Aghead-B/Wall-Tag/design/gun/wiring-gun.png

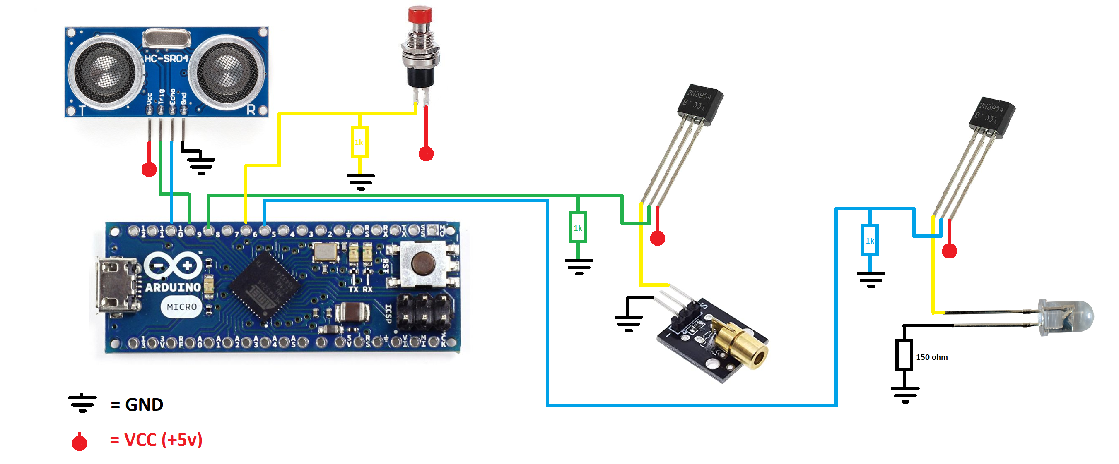
design/gun/wiring-gun.png
