Aghead-B/Wall-Tag/design/console/wiring-console.png

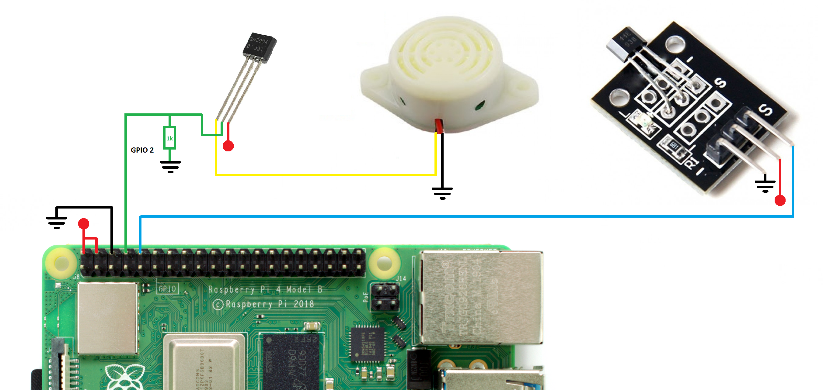
design/console/wiring-console.png
