Aghead-B/Wall-Tag/README.md

# Walltag

Looking for the prototype files? They can be found in the 'prototype' branch.
