Aghead-B/Wall-Tag/design/console/case/Console.step

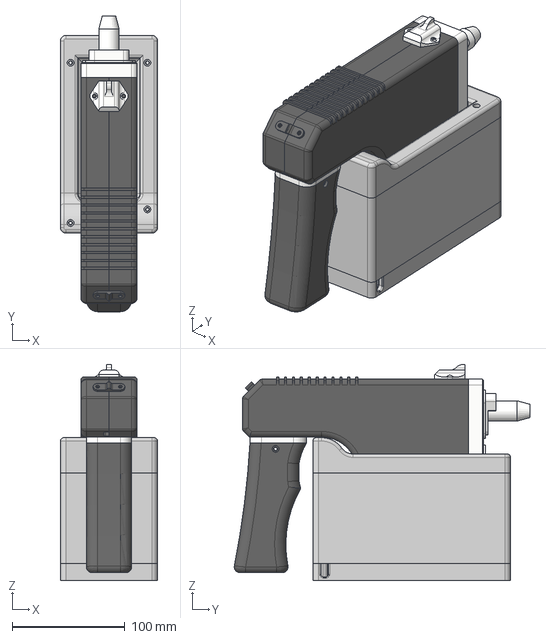
[picture p3: CAD file, 2021-01-11]
design/console/case/Console.step
86.0 x 261.6 x 191.2 mm
