Aghead-B/Wall-Tag/design/console/case/stl/Top.stl

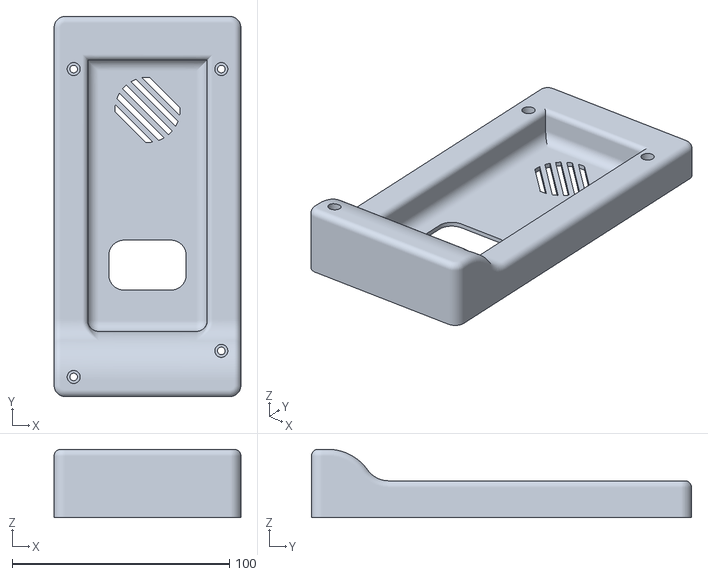
[picture p4: CAD file, 2021-01-11]
design/console/case/stl/Top.stl
86.0 x 175.0 x 31.5
