Aghead-B/Wall-Tag/design/gun/case/Gun.step

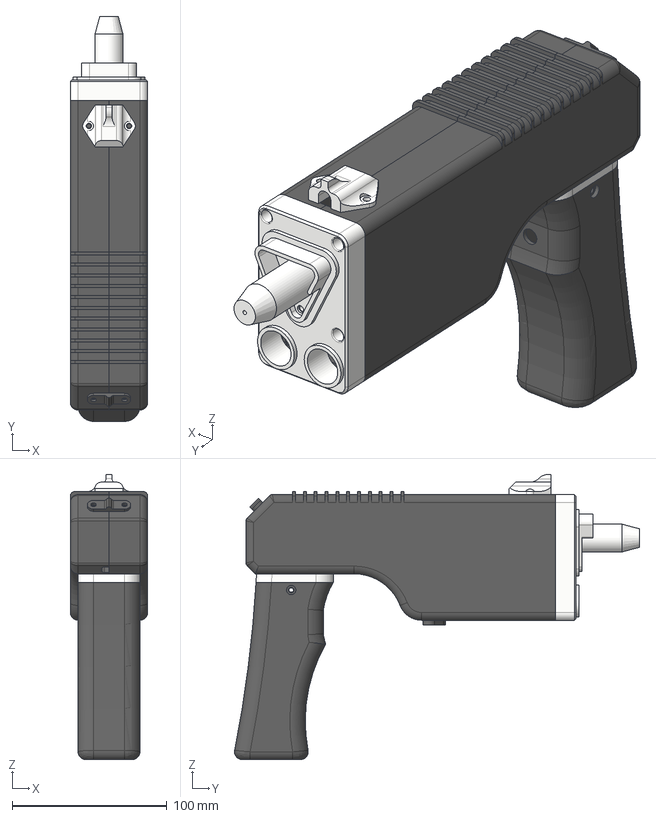
[picture p5: CAD file, 2021-01-11]
design/gun/case/Gun.step
50.0 x 261.6 x 184.2 mm
