Aghead-B/Wall-Tag/design/gun/case/stl/Front.stl

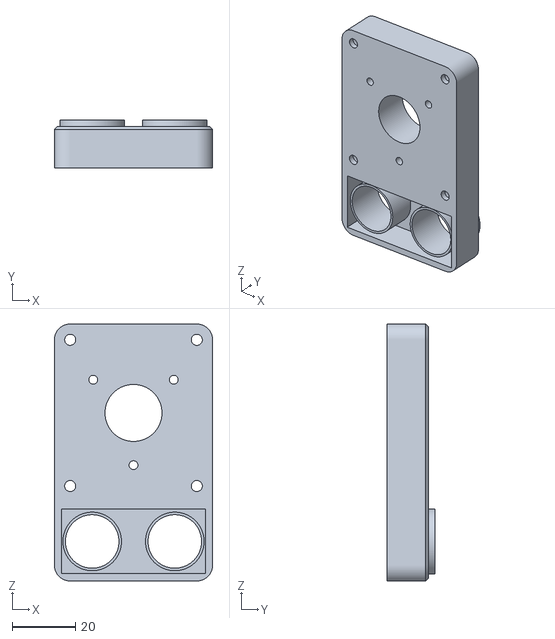
[picture p6: CAD file, 2021-01-11]
design/gun/case/stl/Front.stl
50.0 x 15.2 x 81.2
