Aghead-B/Wall-Tag/design/target-controller/case/Controller.step

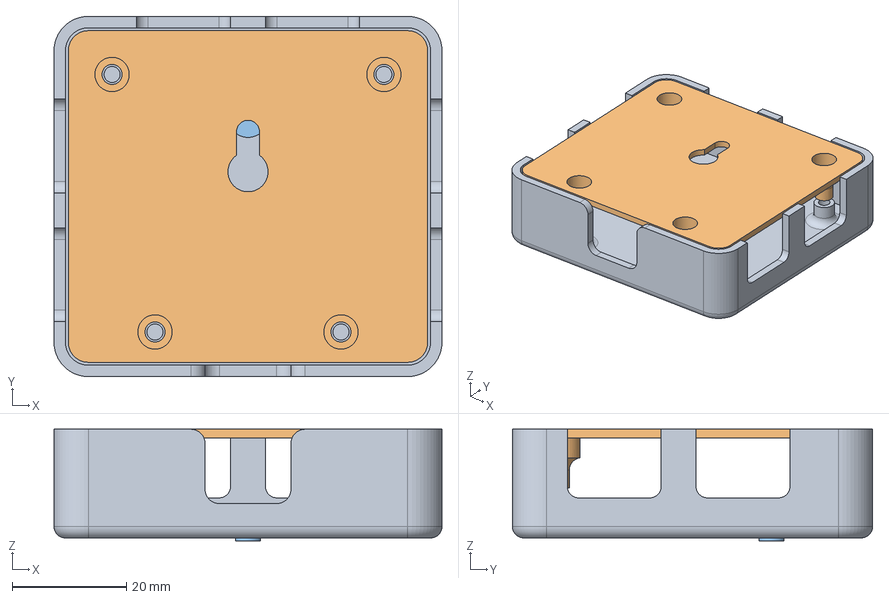
[picture p7: CAD file, 2021-01-11]
design/target-controller/case/Controller.step
67.8 x 63.0 x 19.5 mm
