Aghead-B/Wall-Tag/design/target-controller/case/stl/Case.stl

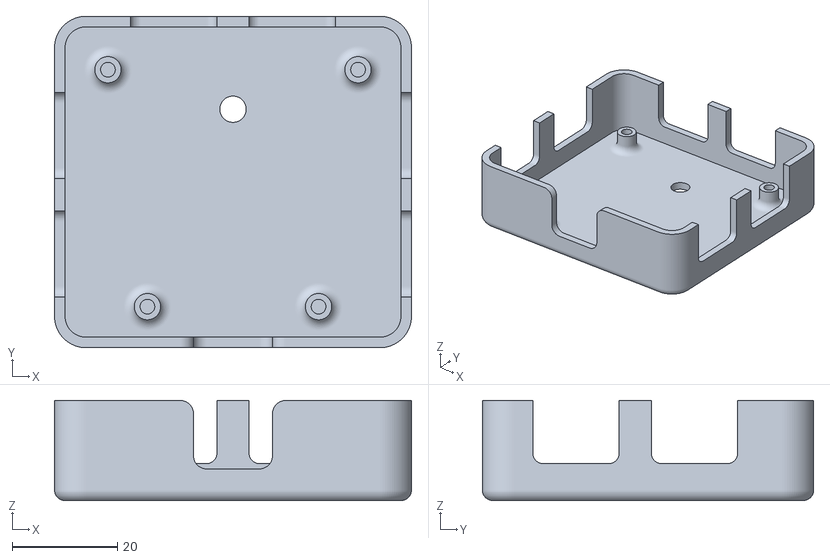
[picture p8: CAD file, 2021-01-11]
design/target-controller/case/stl/Case.stl
67.8 x 62.9 x 19.0
