Aghead-B/Wall-Tag/design/target/case/Target.step

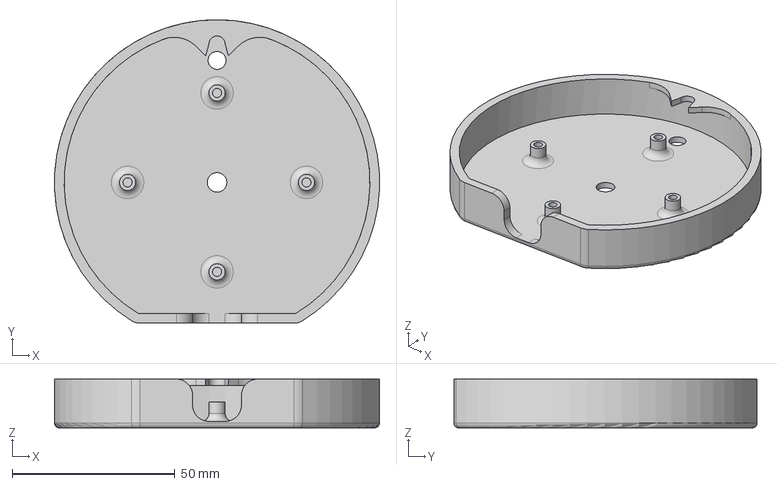
[picture p9: CAD file, 2021-01-11]
design/target/case/Target.step
99.9 x 93.3 x 15.0 mm
