Aghead-B/Wall-Tag/design/target/pcb/outline.dxf

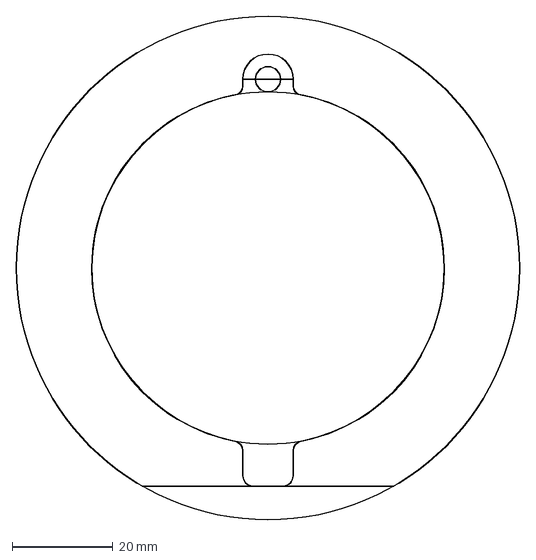
[picture p10: CAD file, 2020-11-24]
design/target/pcb/outline.dxf
100.0 x 100.0 mm
