Aghead-B/Wall-Tag/design/console/case/stl/Speaker mount.stl

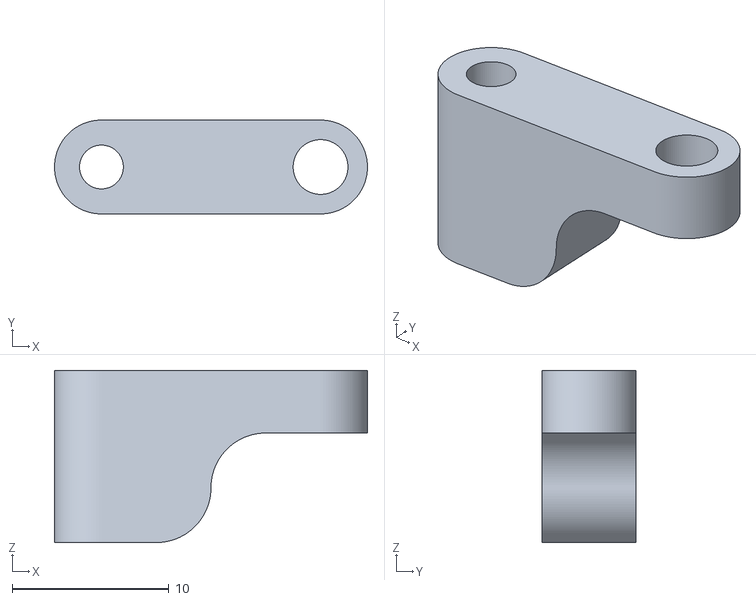
[picture p11: CAD file, 2021-01-11]
design/console/case/stl/Speaker mount.stl
20.0 x 6.00 x 11.0
