Aghead-B/Wall-Tag/design/gun/case/stl/Barrel.stl

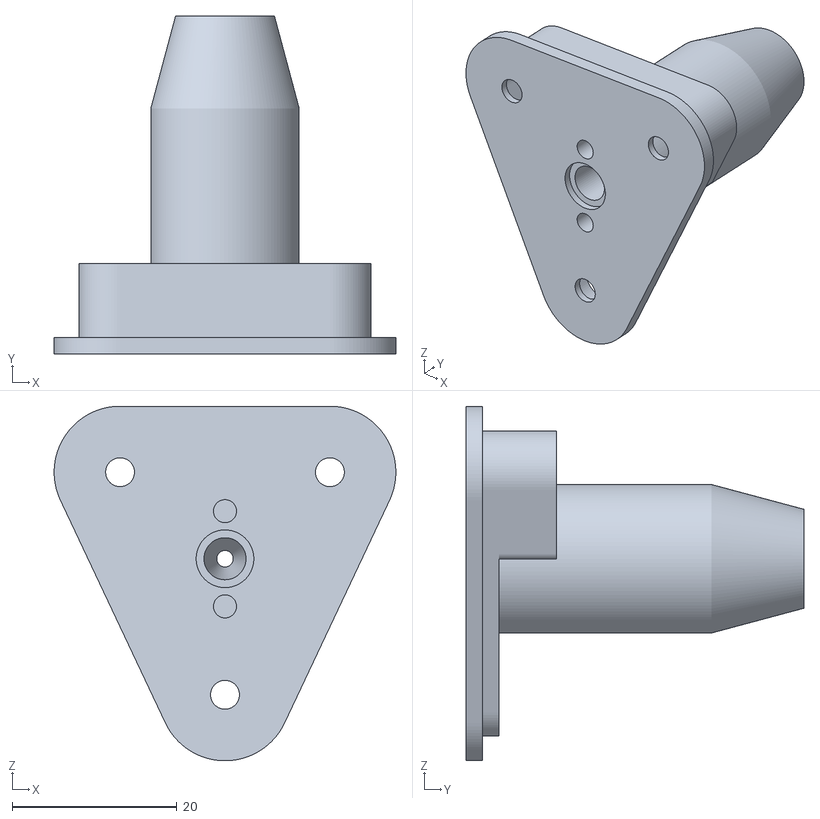
[picture p12: CAD file, 2021-01-11]
design/gun/case/stl/Barrel.stl
41.5 x 41.0 x 43.0
