Aghead-B/Wall-Tag/design/target-controller/case/stl/Button.stl

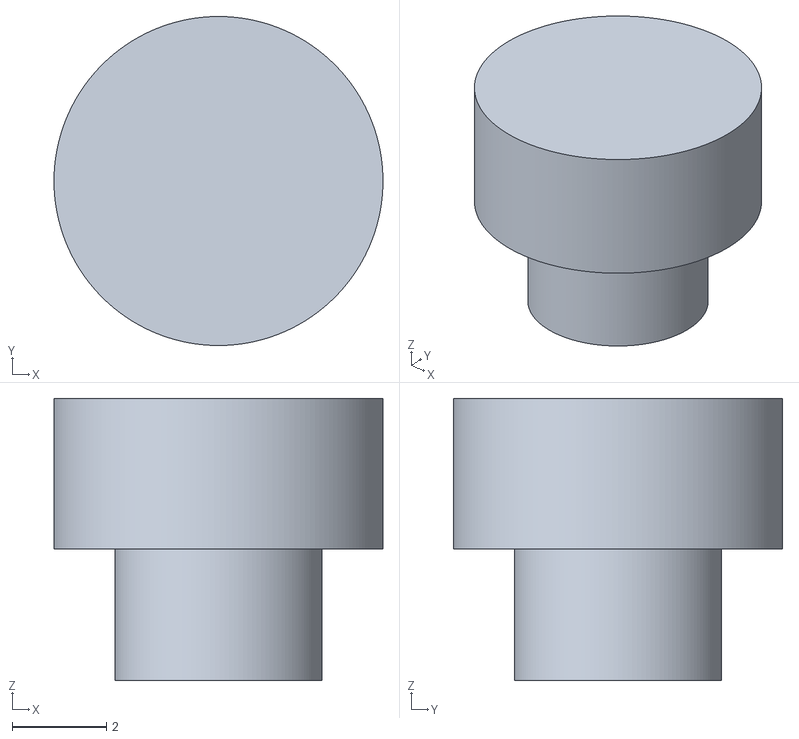
[picture p13: CAD file, 2021-01-11]
design/target-controller/case/stl/Button.stl
7.00 x 7.00 x 6.00
