Aghead-B/Wall-Tag/design/console/case/stl/Mid.stl

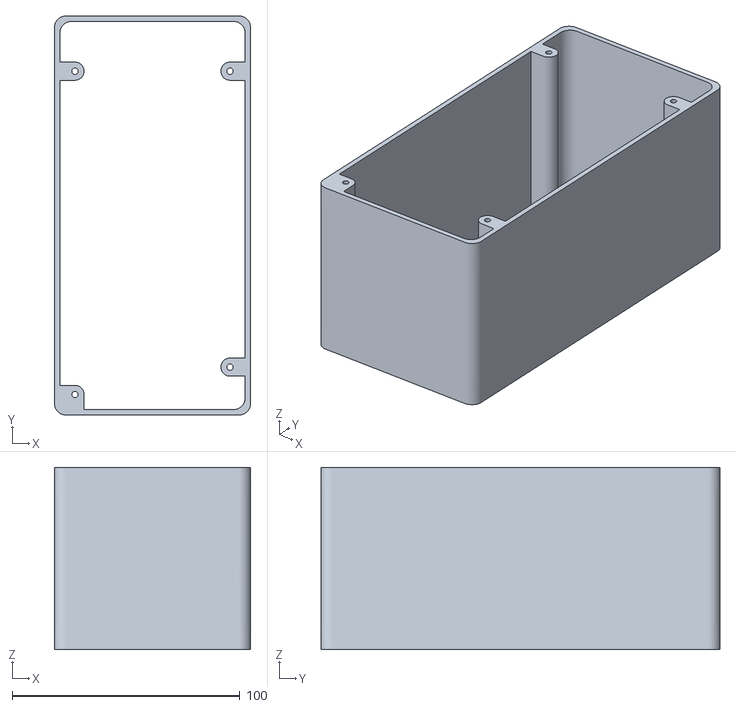
[picture p14: CAD file, 2021-01-11]
design/console/case/stl/Mid.stl
86.0 x 175.0 x 80.0
