Aghead-B/Wall-Tag/design/gun/case/stl/Sight.stl

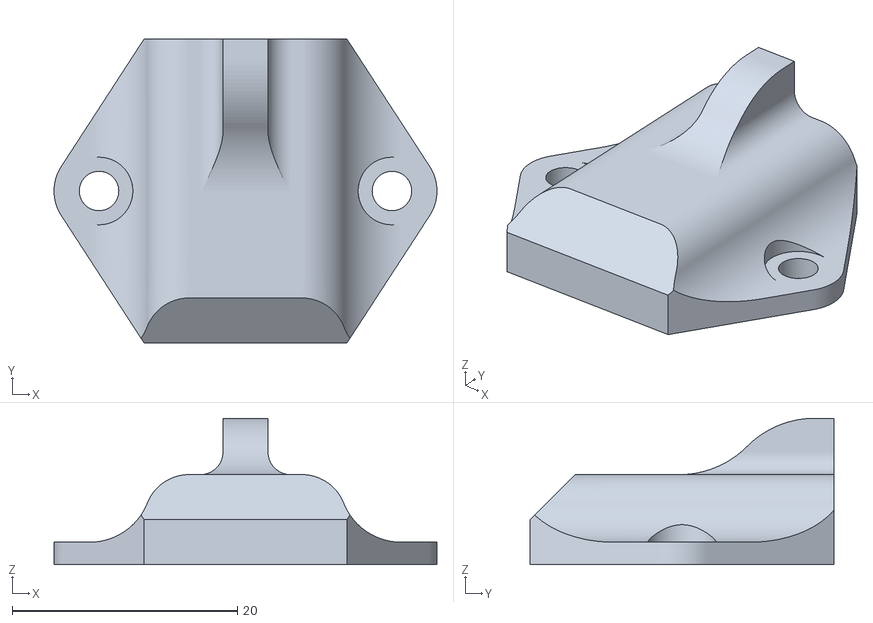
[picture p15: CAD file, 2021-01-11]
design/gun/case/stl/Sight.stl
34.0 x 27.0 x 13.0
