Aghead-B/Wall-Tag/design/target-controller/case/stl/Mount.stl

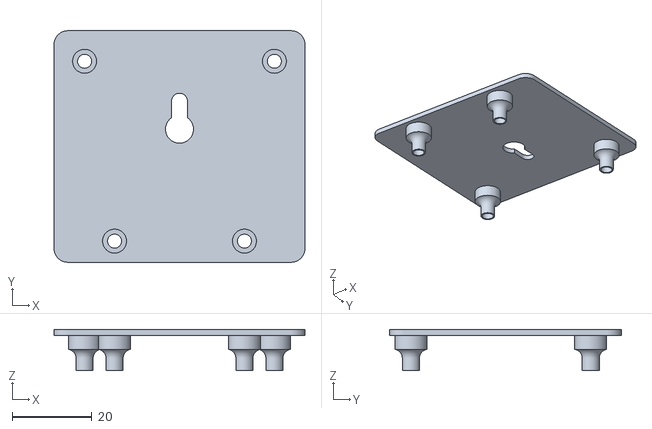
[picture p16: CAD file, 2021-01-11]
design/target-controller/case/stl/Mount.stl
62.8 x 57.9 x 10.3
