Aghead-B/Wall-Tag/design/console/case/stl/Bottom.stl

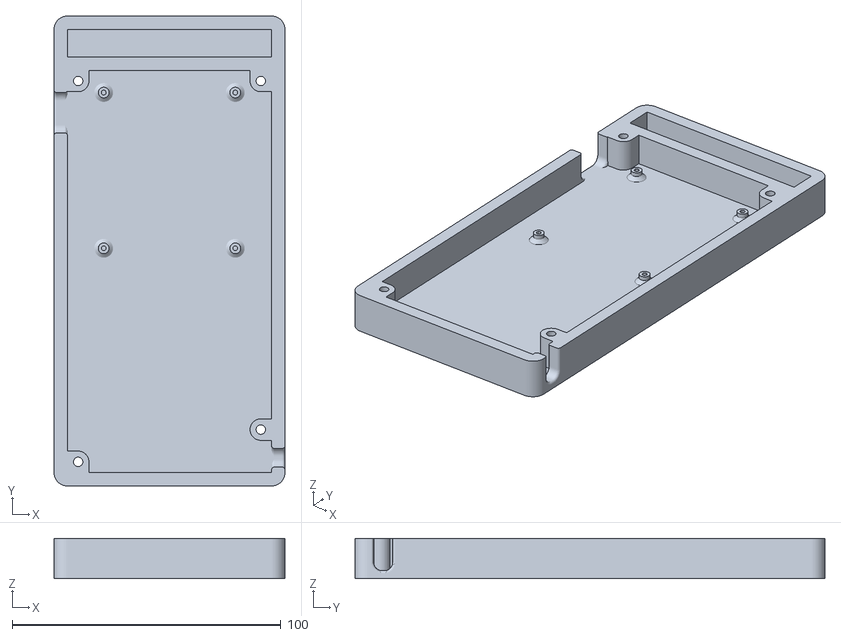
[picture p17: CAD file, 2021-01-11]
design/console/case/stl/Bottom.stl
86.0 x 175.0 x 15.0
