Aghead-B/Wall-Tag/design/console/case/stl/Sensor mount.stl

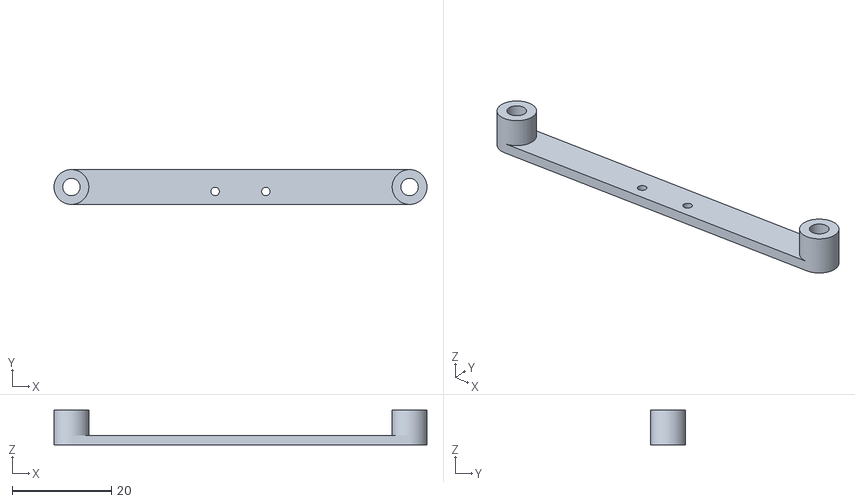
[picture p19: CAD file, 2021-01-11]
design/console/case/stl/Sensor mount.stl
75.0 x 7.00 x 7.00
