Aghead-B/Wall-Tag/design/gun/case/stl/Handvat Mount.stl

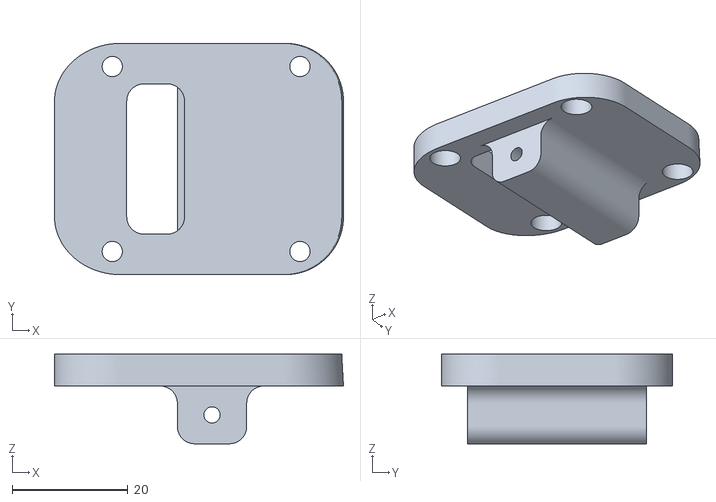
[picture p20: CAD file, 2021-01-11]
design/gun/case/stl/Handvat Mount.stl
50.0 x 40.0 x 15.5
