Aghead-B/Wall-Tag/design/gun/case/stl/Connector bottom.stl

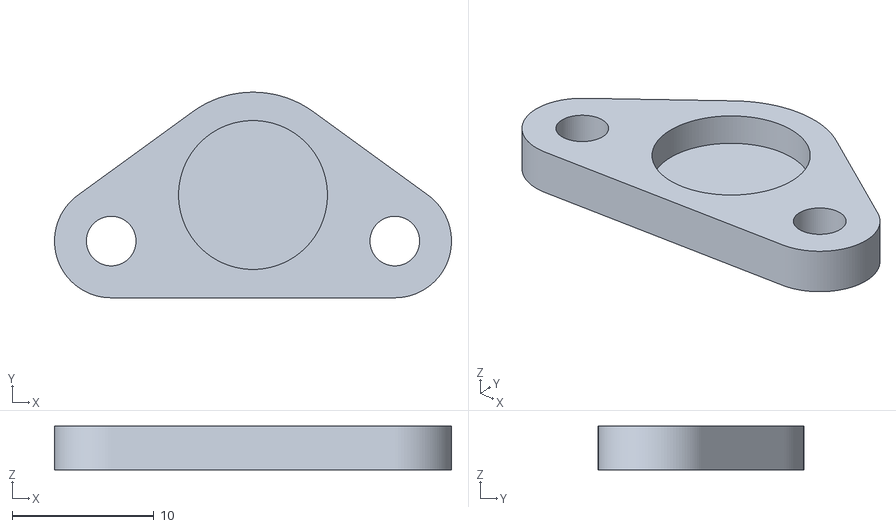
[picture p21: CAD file, 2021-01-11]
design/gun/case/stl/Connector bottom.stl
28.0 x 14.5 x 3.10
