Aghead-B/Wall-Tag/design/gun/case/stl/LED plate.stl

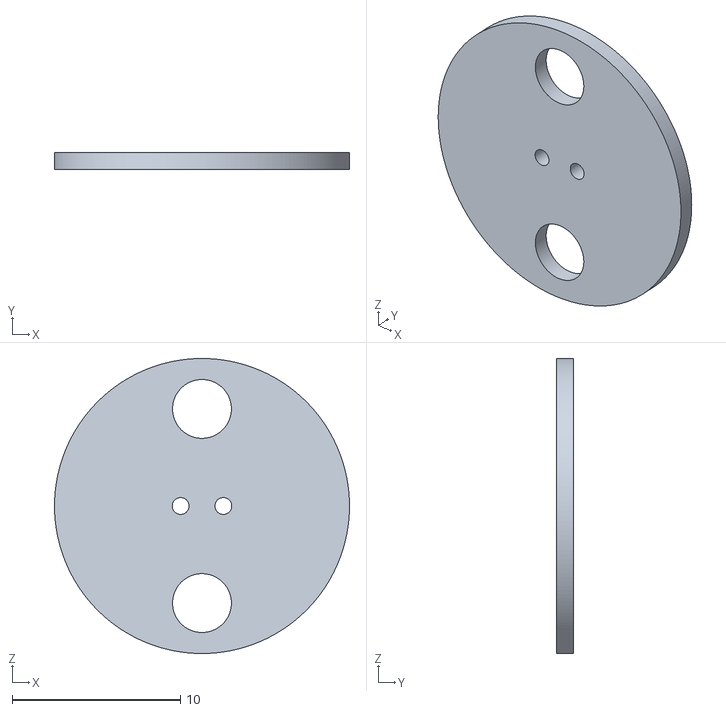
[picture p22: CAD file, 2021-01-11]
design/gun/case/stl/LED plate.stl
17.5 x 1.00 x 17.5
