Aghead-B/Wall-Tag/design/gun/case/stl/Handvat.stl

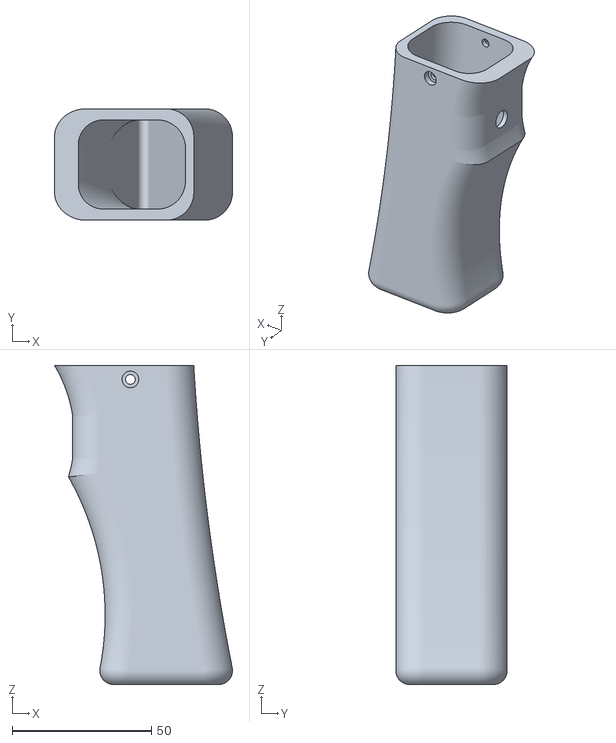
[picture p23: CAD file, 2021-01-11]
design/gun/case/stl/Handvat.stl
63.9 x 40.0 x 114.5
