Aghead-B/Wall-Tag/design/gun/case/stl/Left.stl

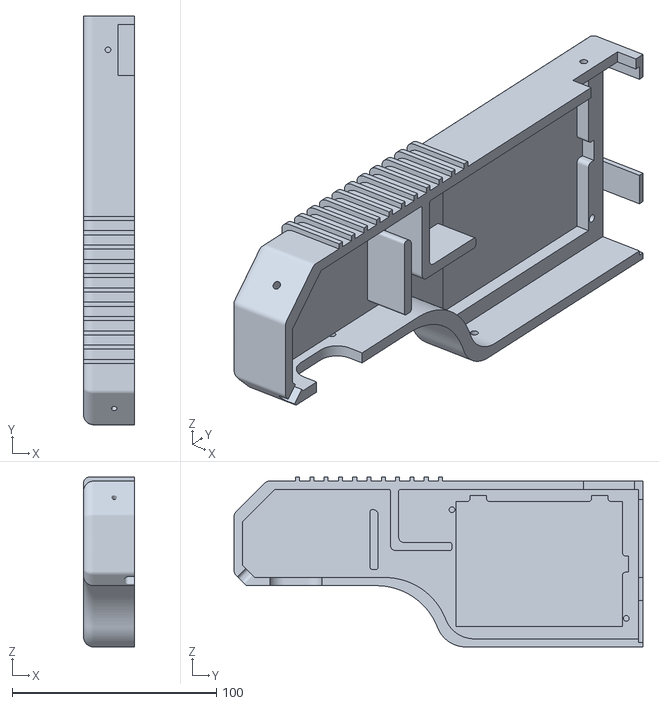
[picture p24: CAD file, 2021-01-11]
design/gun/case/stl/Left.stl
25.0 x 200.0 x 83.2
