Aghead-B/Wall-Tag/design/gun/case/stl/Connector top.stl

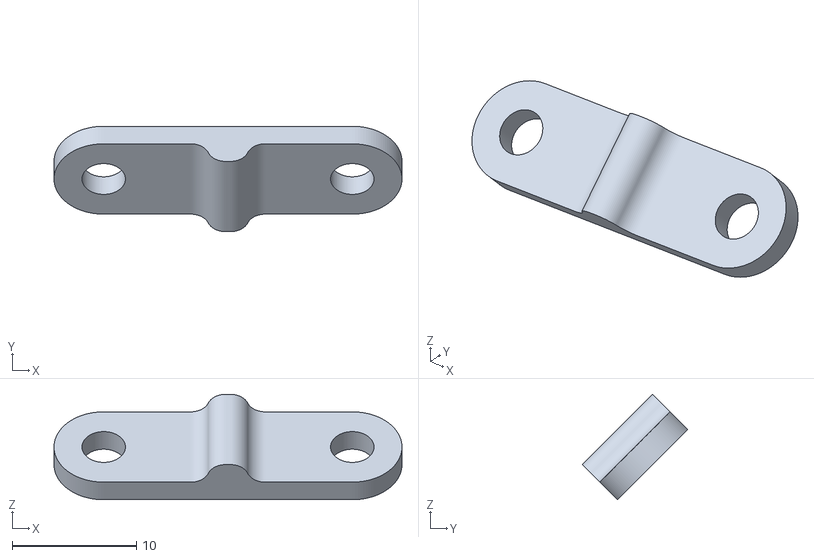
[picture p25: CAD file, 2021-01-11]
design/gun/case/stl/Connector top.stl
28.0 x 8.49 x 8.49
