Aghead-B/Wall-Tag/(list of files, cad)

Other CAD files:
design/console/case/Console.f3z
design/gun/case/Gun.f3z
design/target-controller/case/Controller.f3d
design/target/case/Target.f3d
design/target/case/Target.stl
