Aghead-B/Wall-Tag/design/target/pcb/pcb.kicad_pcb

## KiCad design design/target/pcb/pcb.kicad_pcb (2020-11-24)

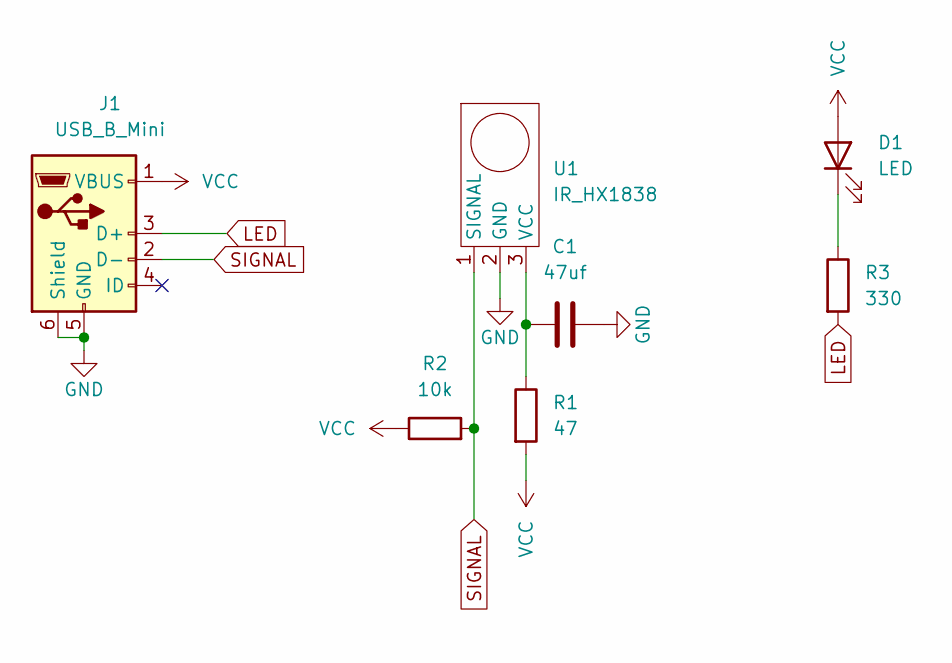
[picture p26: schematic pcb.kicad_sch]

Parts:
C1: 47uf; C_0805_2012Metric_Pad1.15x1.40mm_HandSolder
D1: LED; LED_D5.0mm
J1: USB_B_Mini; U-M-M5DD-W-1
R1: 47; R_0805_2012Metric_Pad1.15x1.40mm_HandSolder
R2: 10k; R_0805_2012Metric_Pad1.15x1.40mm_HandSolder
R3: 330; R_0805_2012Metric_Pad1.15x1.40mm_HandSolder
U1: IR_HX1838; ir_sensor

Connections:
GND: C1.2, J1.5 (GND), J1.6 (Shield), U1.2 (GND)
LED: J1.3 (D+), R3.2
unnamed: C1.1, R1.1, U1.3 (VCC)
unnamed: D1.1 (K), R3.1
SIGNAL: J1.2 (D-), R2.2, U1.1 (SIGNAL)
VCC: D1.2 (A), J1.1 (VBUS), R1.2, R2.1

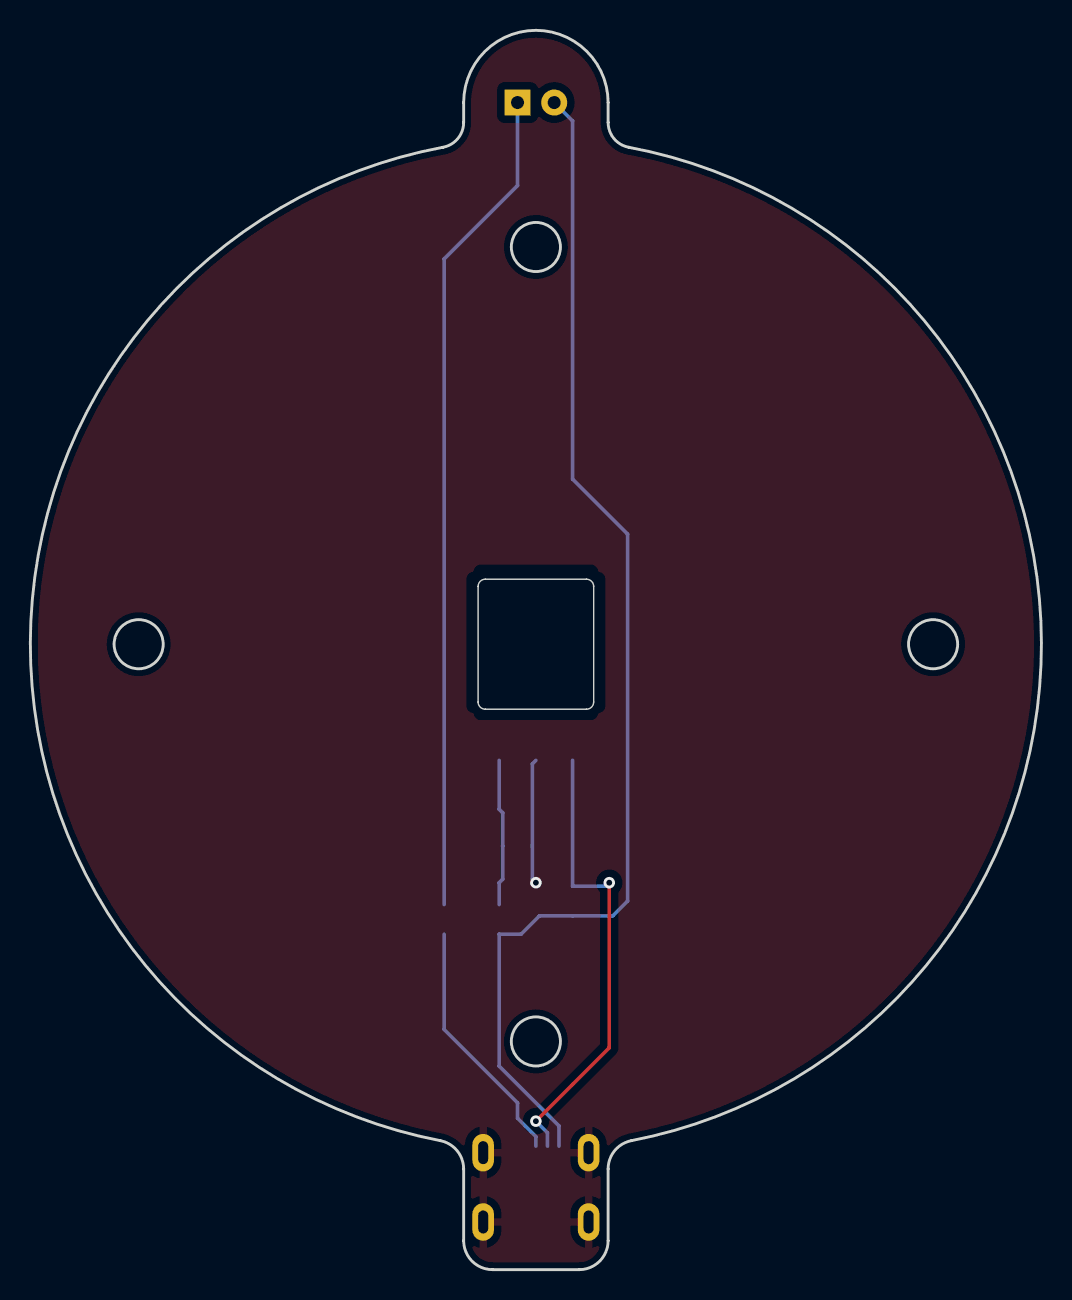
[picture p27: board pcb.kicad_pcb from above]

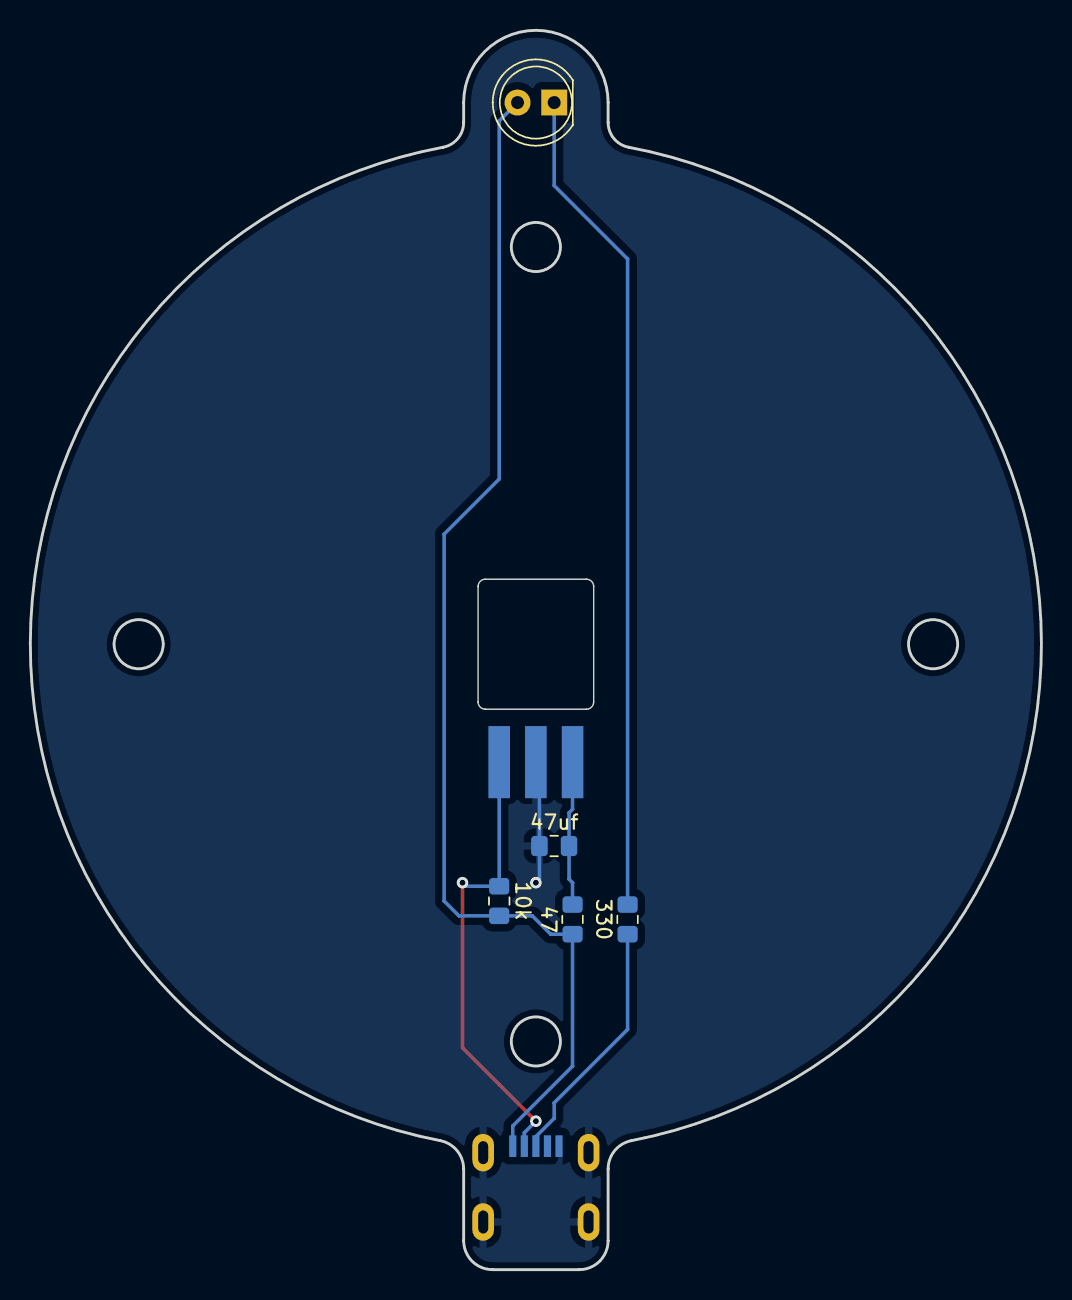
[picture p28: board pcb.kicad_pcb from below]

Board: 2 copper layers, 70.0 x 85.8 mm, 7 parts (7 on the bottom side), 6 nets.
