Aghead-B/Wall-Tag/design/target-controller/pcb/controller.kicad_pcb

## KiCad design design/target-controller/pcb/controller.kicad_pcb (2020-12-01)

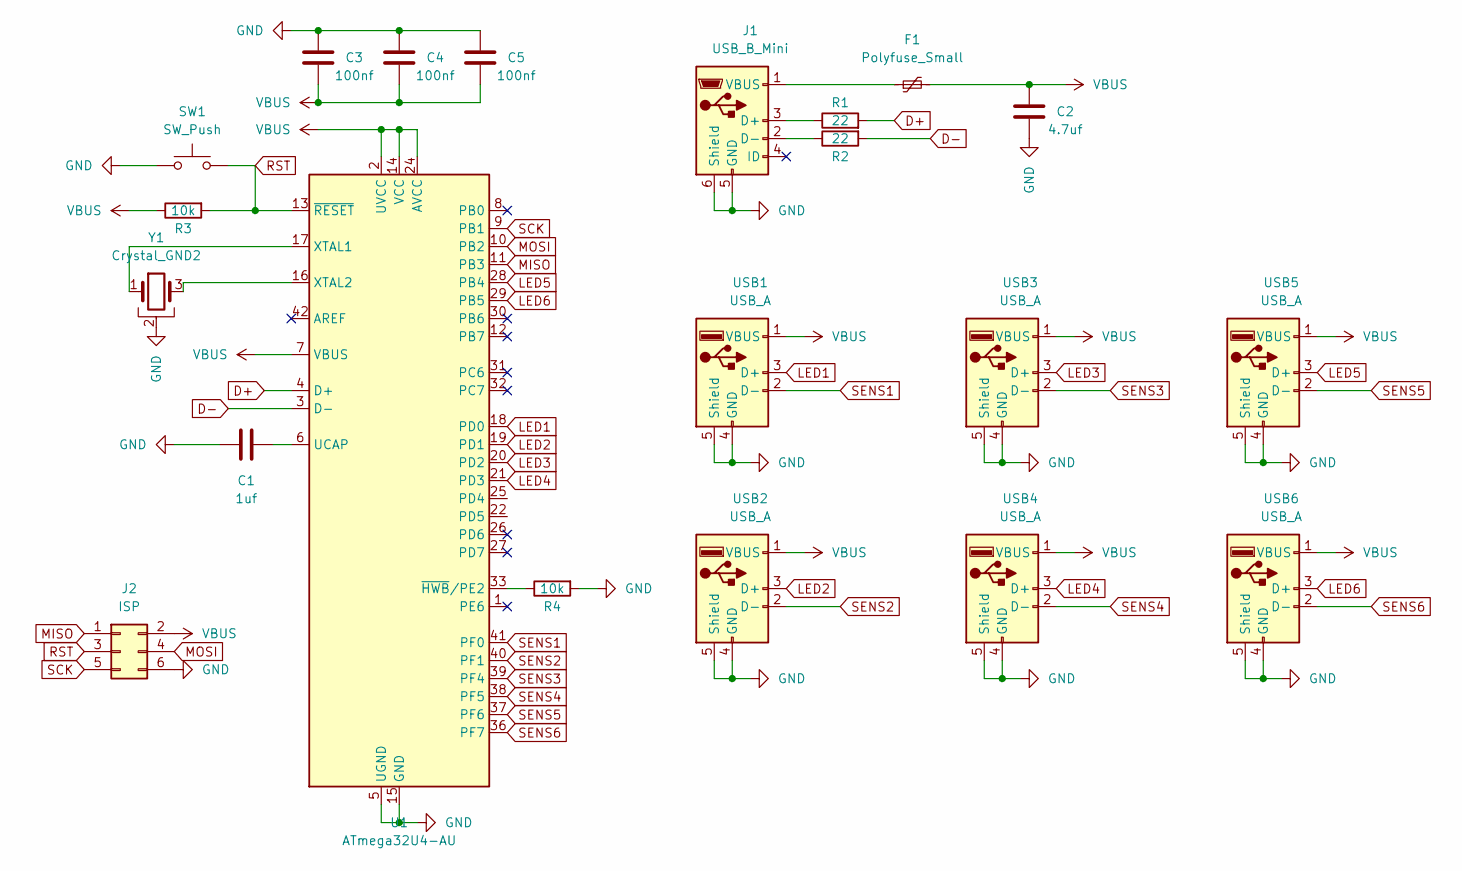
[picture p29: schematic controller.kicad_sch]

Parts:
C1: 1uf; C_0805_2012Metric_Pad1.15x1.40mm_HandSolder
C2: 4.7uf; C_0805_2012Metric_Pad1.15x1.40mm_HandSolder
C3, C4, C5: 100nf; C_0805_2012Metric_Pad1.15x1.40mm_HandSolder
F1: Polyfuse_Small; R_0805_2012Metric_Pad1.15x1.40mm_HandSolder
J1: USB_B_Mini; U-M-M5DD-W-1
J2: ISP; isp_standard
R1, R2: 22; R_0805_2012Metric_Pad1.15x1.40mm_HandSolder
R3, R4: 10k; R_0805_2012Metric_Pad1.15x1.40mm_HandSolder
SW1: SW_Push; SW_SPST_TL3342
U1: ATmega32U4-AU; TQFP-44_10x10mm_P0.8mm
USB1, USB2, USB3, USB4, USB5, USB6: USB_A; U-A-24DD-Y-1
Y1: Crystal_GND2; Resonator_SMD_muRata_CSTNExxV-3Pin-p1.2

Connections:
D+: R1.2, U1.4 (D+)
D-: R2.2, U1.3 (D-)
GND: C1.2, C2.2, C3.1, C4.1, C5.1, J1.5 (GND), J1.6 (Shield), J2.6, R4.2, SW1.1, U1.5 (UGND), U1.15 (GND), U1.23 (GND), U1.35 (GND), U1.43 (GND), USB1.4 (GND), USB1.5 (Shield), USB2.4 (GND), USB2.5 (Shield), USB3.4 (GND), USB3.5 (Shield), USB4.4 (GND), USB4.5 (Shield), USB5.4 (GND), USB5.5 (Shield), USB6.4 (GND), USB6.5 (Shield), Y1.2
LED1: U1.18 (PD0), USB1.3 (D+)
LED2: U1.19 (PD1), USB2.3 (D+)
LED3: U1.20 (PD2), USB3.3 (D+)
LED4: U1.21 (PD3), USB4.3 (D+)
LED5: U1.28 (PB4), USB5.3 (D+)
LED6: U1.29 (PB5), USB6.3 (D+)
MISO: J2.1, U1.11 (PB3)
MOSI: J2.4, U1.10 (PB2)
unnamed: C1.1, U1.6 (UCAP)
unnamed: F1.1, J1.1 (VBUS)
unnamed: J1.2 (D-), R2.1
unnamed: J1.3 (D+), R1.1
unnamed: R4.1, U1.33 (~HWB~/PE2)
unnamed: U1.17 (XTAL1), Y1.1
unnamed: U1.16 (XTAL2), Y1.3
RST: J2.3, R3.2, SW1.2, U1.13 (~RESET)
SCK: J2.5, U1.9 (PB1)
SENS1: U1.41 (PF0), USB1.2 (D-)
SENS2: U1.40 (PF1), USB2.2 (D-)
SENS3: U1.39 (PF4), USB3.2 (D-)
SENS4: U1.38 (PF5), USB4.2 (D-)
SENS5: U1.37 (PF6), USB5.2 (D-)
SENS6: U1.36 (PF7), USB6.2 (D-)
VBUS: C2.1, C3.2, C4.2, C5.2, F1.2, J2.2, R3.1, U1.2 (UVCC), U1.7 (VBUS), U1.14 (VCC), U1.24 (AVCC), U1.34 (VCC), U1.44 (AVCC), USB1.1 (VBUS), USB2.1 (VBUS), USB3.1 (VBUS), USB4.1 (VBUS), USB5.1 (VBUS), USB6.1 (VBUS)

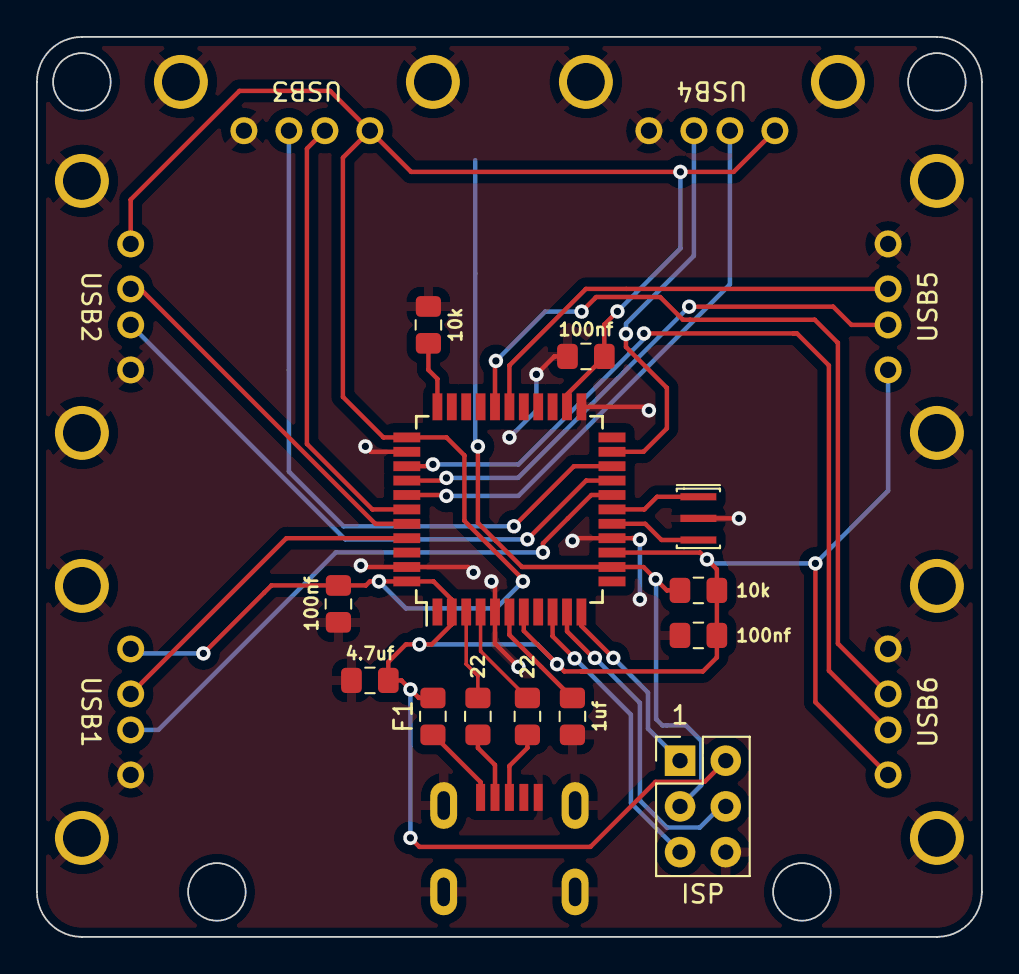
[picture p30: board controller.kicad_pcb from above]

Board: 2 copper layers, 52.5 x 50.0 mm, 21 parts (1 on the bottom side), 27 nets.
