Aghead-B/Wall-Tag/arduino/gun/gun.ino

/*
 * IRremote: IRsendNecStandardDemo
 *
 *  Demonstrates sending NEC IR codes in standard format with 16 bit Address  8bit Data
 *
 *  Created on: 15.09.2020
 *  Copyright (C) 2020  Armin Joachimsmeyer
 *  armin.joachimsmeyer@gmail.com
 *
 *  This file is part of Arduino-RobotCar https://github.com/z3t0/Arduino-IRremote.
 *
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
 *  You should have received a copy of the GNU General Public License
 *  along with this program.  If not, see <http://www.gnu.org/licenses/gpl.html>.
 */
// Deze sketch is gebaseerd op de democode van IRRemote, om een juist commando te versturen via IR.
// Hierin is het lezen van de afstand en het aanzetten van de laser diode geintegreerd.

#include <IRremote.h>
IRsend IrSender;

const int buttonPin = 6;     // the number of the pushbutton pin
// IR led is on D5
const int laserPin = 8;
int buttonState = 0;         // variable for reading the pushbutton status

// Deze zijn voor de afstandssensor
const int trigPin = 9;
const int echoPin = 10;

long duration;
int distance;
bool startTrue = false;

void setup() {
    pinMode(buttonPin, INPUT);
    pinMode(laserPin, OUTPUT);
    pinMode(trigPin, OUTPUT); // Sets the trigPin as an Output
    pinMode(echoPin, INPUT); // Sets the echoPin as an Input
    pinMode(LED_BUILTIN, OUTPUT);
    Serial.begin(9600);
}

uint16_t sAddress = 0xa90;
uint8_t sCommand = 0x34;
uint8_t sRepeats = 0;
uint8_t iteration = 0;

void loop(){
     if (Serial.available() > 0){
      String startGun = Serial.readString();
      if ( startGun.indexOf("on") > -1 ){
       startTrue = true;
      } else if ( startGun.indexOf("off") > -1 ){
        startTrue = false;
      }
     }
    printDistance();
    buttonState = digitalRead(buttonPin);
    if (buttonState == HIGH && startTrue == true) {
        digitalWrite(laserPin, HIGH);
        shootIR();
        delay(50);
    } else {
        delay(50);
        digitalWrite(laserPin, LOW);
    }
}

void shootIR() {
    IrSender.sendNECStandard(sAddress, sCommand, sRepeats);
    sAddress++;
    sCommand++;
}

void printDistance() {
    digitalWrite(trigPin, LOW);
    delayMicroseconds(2);
    // Sets the trigPin on HIGH state for 10 micro seconds
    digitalWrite(trigPin, HIGH);
    delayMicroseconds(10);
    digitalWrite(trigPin, LOW);
    // Reads the echoPin, returns the sound wave travel time in microseconds
    duration = pulseIn(echoPin, HIGH);
    // Calculating the distance
    distance= duration*0.034/2;
    // Prints the distance on the Serial Monitor
    Serial.println(distance);
}

void serialFlush(){
  while(Serial.available() > 0) {
    char t = Serial.read();
  }
}   
