Aghead-B/Wall-Tag/(commit log)

2020-10-21 Upload prototype gun/target files
2020-11-24 upload target design
    [outline.dxf, pcb.kicad_pcb, pcb.kicad_sch]
2020-11-24 Upload target pcb/case
    [Target case.step, Target case.stl]
2020-12-01 Target controller PCB design
    [controller.kicad_pcb, controller.kicad_sch, outline.dxf, pcb.kicad_pcb, pcb.kicad_sch]
2020-12-08 Code voor de Targets
2020-12-17 Update PCBs
    [controller-B_Cu.gbl, controller-B_Mask.gbs, controller-B_Paste.gbp, controller-B_Silkscreen.gbo, controller-Edge_Cuts.gm1, controller-F_Cu.gtl, controller-F_Mask.gts, controller-F_Paste.gtp]
2020-12-17 Move arduino code/update pins
2020-12-19 Upload gun design/update target design
    [Gun design.step, Gun design.stl, Target case.step, Target case.stl]
2020-12-28 Console design in fushion
    [Console.f3d]
2020-12-28 Console 2.0
    [Console_2.0.f3d]
2021-01-07 Add hall effect sensor
2021-01-07 Allow hall effect sensing before target/gun
2021-01-11 Add hall effect/distance sensor check to game
2021-01-11 Remove old files, update all designs and update web pages
    [Barrel.stl, Bottom.stl, Button.stl, Case.stl, Connector bottom.stl, Connector top.stl, Console.f3d, Console.f3z]
2021-01-11 Remove kicad backup files
